enzoevers/piezo2midi/README.md

# piezo2midi

This project contains the hardware and software to read piezo inputs and convert them to a midi signal.

The main usecase is electronic drums. But it should be generic enough to be use by any piezo input.
