enzoevers/piezo2midi/Docs/Images/Piezo/FallstadPiezoModuleCircuit.png

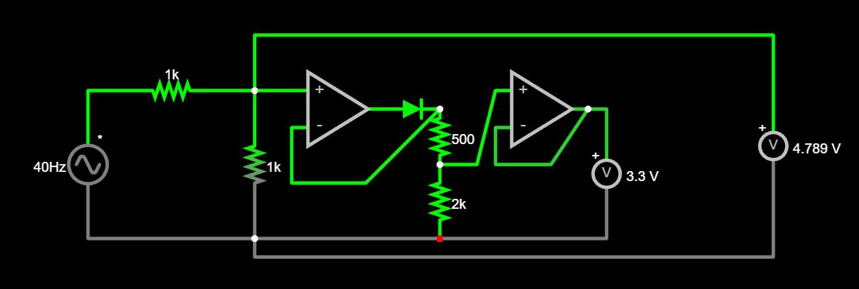
Docs/Images/Piezo/FallstadPiezoModuleCircuit.png
