enzoevers/piezo2midi/Docs/Images/Piezo/PiezoModuleInputCircuit.png

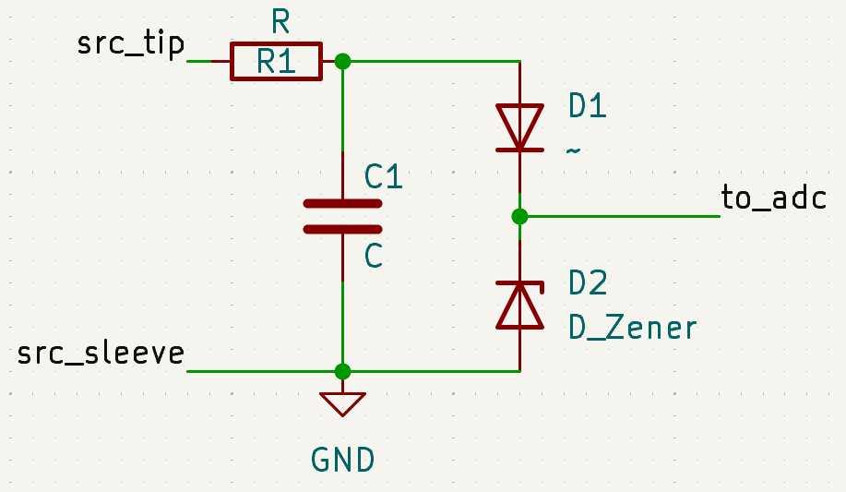
Docs/Images/Piezo/PiezoModuleInputCircuit.png
