enzoevers/piezo2midi/Docs/Images/Piezo/Scope/AlesisPad3v3ZenerAndDiodeHit.png

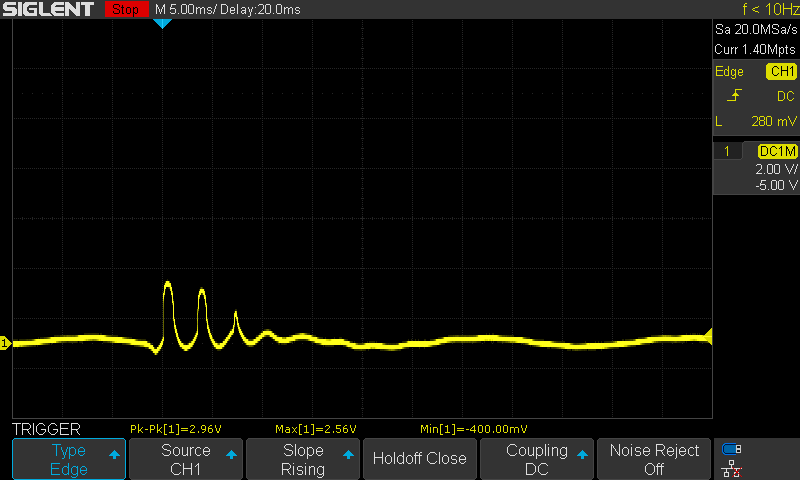
Docs/Images/Piezo/Scope/AlesisPad3v3ZenerAndDiodeHit.png
