enzoevers/piezo2midi/Docs/Images/Piezo/Scope/AlesisPad7v5ZenerAndDiodeHit1.png

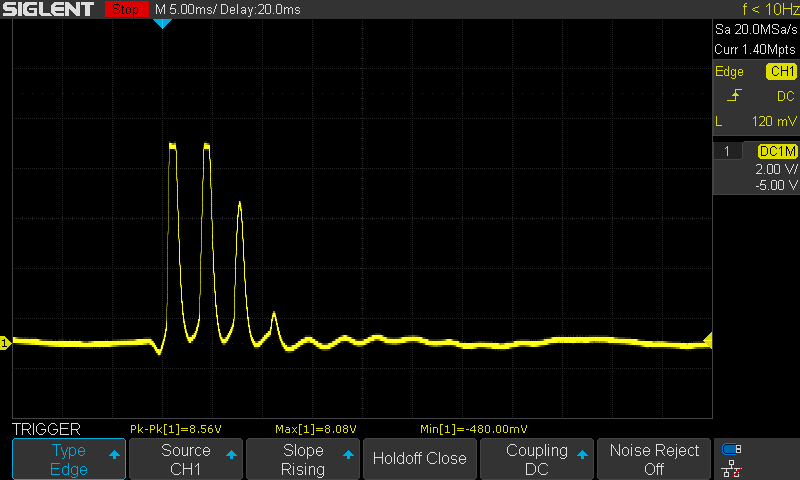
Docs/Images/Piezo/Scope/AlesisPad7v5ZenerAndDiodeHit1.png
