enzoevers/piezo2midi/Docs/Images/Piezo/Scope/AlesisPad7v5ZenerHit1.png

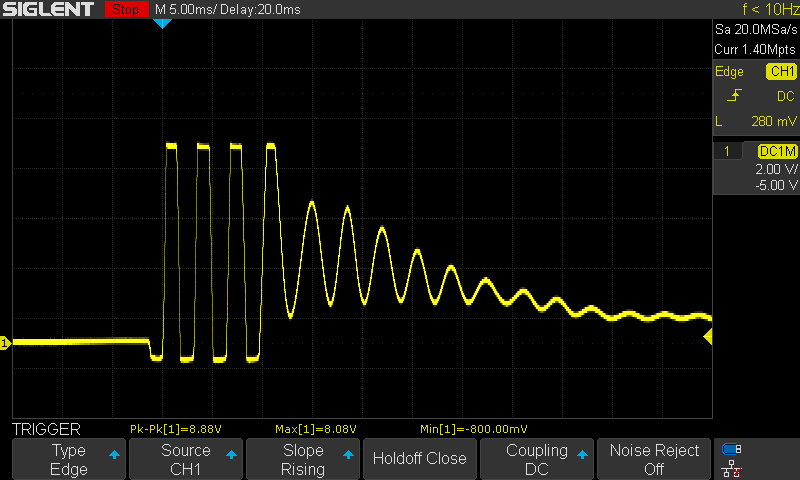
Docs/Images/Piezo/Scope/AlesisPad7v5ZenerHit1.png
