enzoevers/piezo2midi/Docs/Images/Piezo/Scope/AlesisPadHit1.png

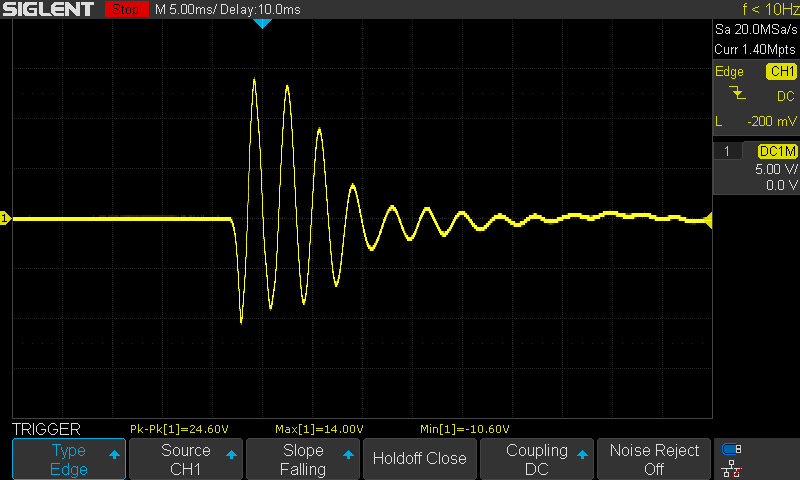
Docs/Images/Piezo/Scope/AlesisPadHit1.png
