enzoevers/piezo2midi/Docs/Images/Piezo/Scope/DIY8InchHit1.png

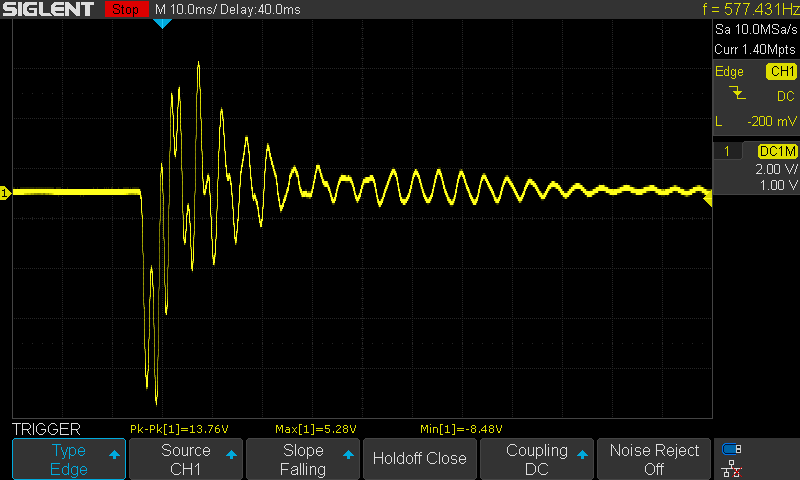
Docs/Images/Piezo/Scope/DIY8InchHit1.png
