enzoevers/piezo2midi/Docs/Images/Piezo/Scope/DIY10InchHit1.png

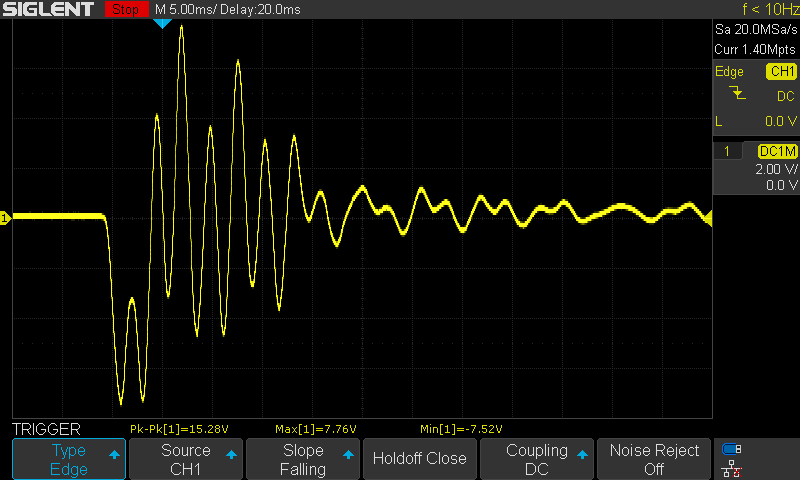
Docs/Images/Piezo/Scope/DIY10InchHit1.png
