enzoevers/piezo2midi/Docs/Images/Piezo/Scope/DIY10InchHit2.png

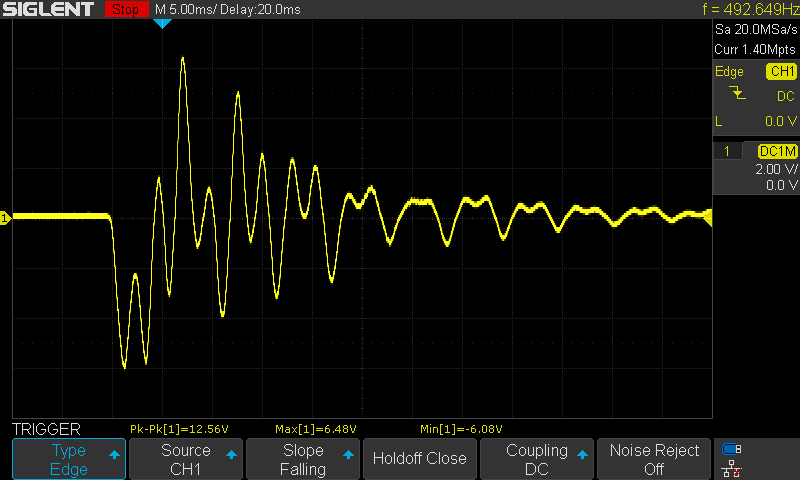
Docs/Images/Piezo/Scope/DIY10InchHit2.png
