enzoevers/piezo2midi/Docs/Images/Piezo/Scope/OpAmpScalerVcc20V.png

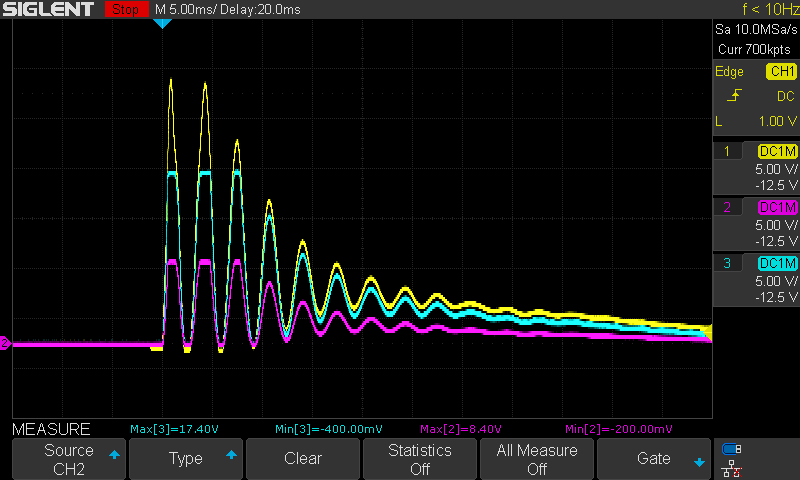
Docs/Images/Piezo/Scope/OpAmpScalerVcc20V.png
