enzoevers/piezo2midi/Docs/Images/Piezo/Scope/OpAmpVcc20VDiodeOnOutput.png

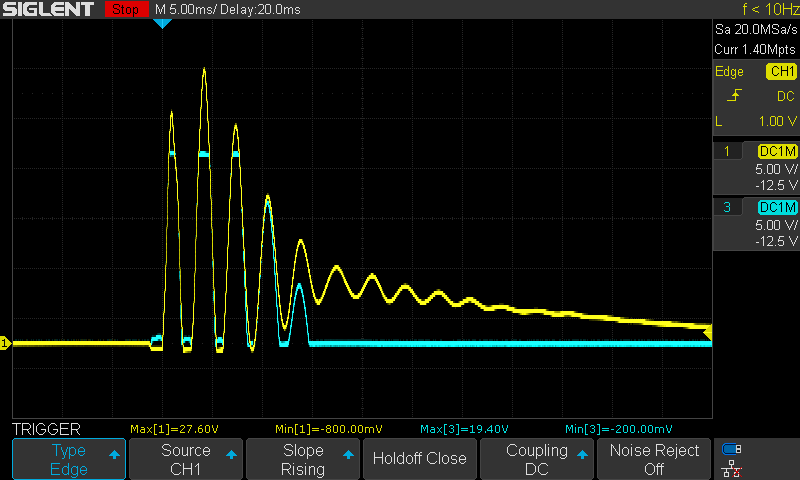
Docs/Images/Piezo/Scope/OpAmpVcc20VDiodeOnOutput.png
