enzoevers/piezo2midi/KiCAD/MouserModels/LIB_MCP3008-I_SL/MCP3008-I_SL/3D/MCP3008-I_SL.stp

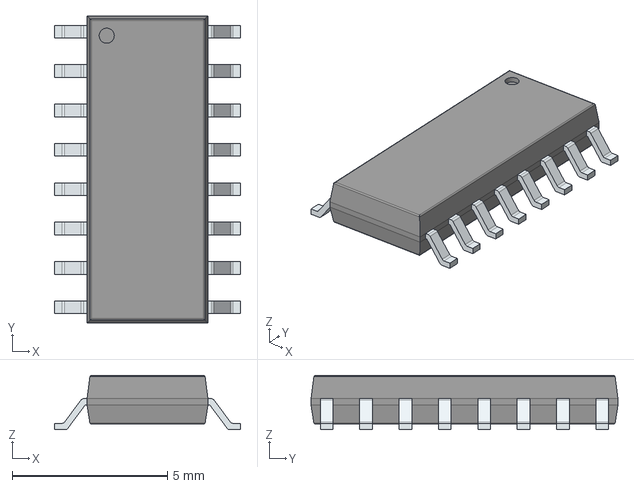
[picture p48: CAD file, 2026-08-01]
KiCAD/MouserModels/LIB_MCP3008-I_SL/MCP3008-I_SL/3D/MCP3008-I_SL.stp
6.00 x 9.90 x 1.75 mm
PinsArrayLR
