enzoevers/piezo2midi/KiCAD/MouserModels/LIB_S3B-PH-SM4-TB_LF__SN_/S3B-PH-SM4-TB_LF__SN_/3D/S3B-PH-SM4-TB_LF__SN_.stp

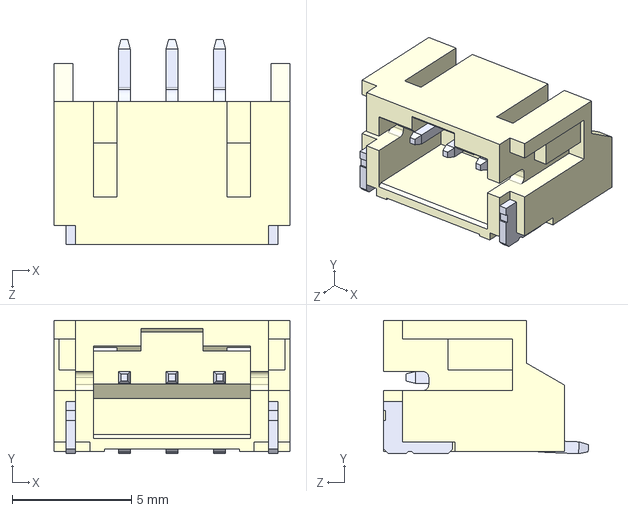
[picture p49: CAD file, 2026-08-01]
KiCAD/MouserModels/LIB_S3B-PH-SM4-TB_LF__SN_/S3B-PH-SM4-TB_LF__SN_/3D/S3B-PH-SM4-TB_LF__SN_.stp
9.90 x 5.60 x 8.60 mm
