enzoevers/piezo2midi/KiCAD/PiezoCircuit/PiezoCircuit/PiezoCircuit.kicad_pcb

## KiCad design KiCAD/PiezoCircuit/PiezoCircuit/PiezoCircuit.kicad_pcb (2026-08-01)

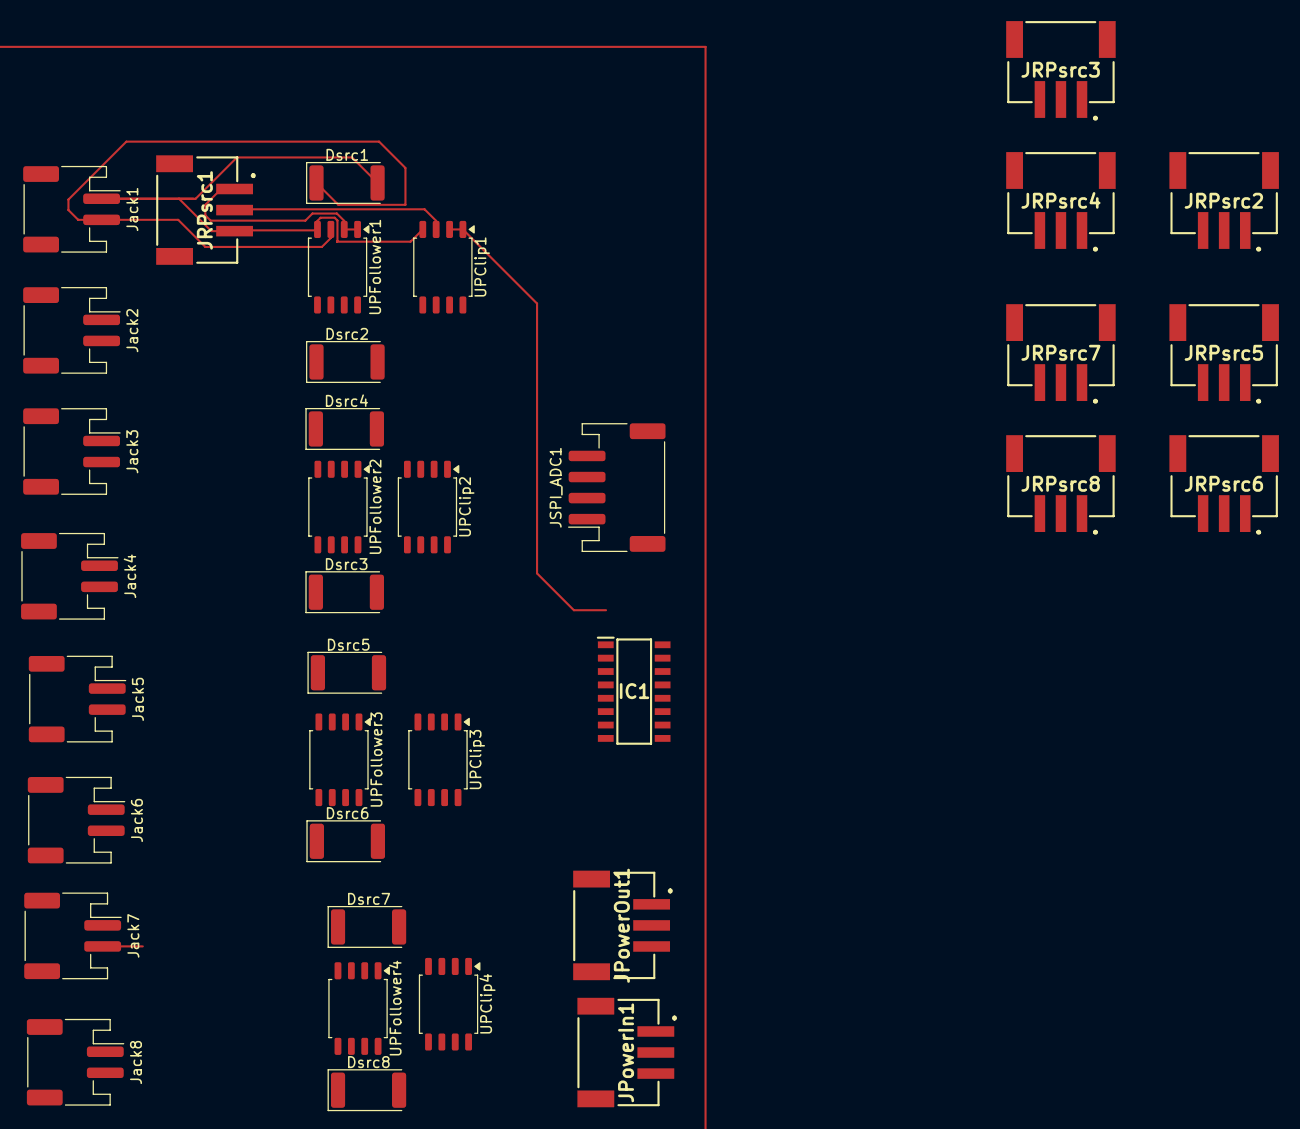
[picture p50: board PiezoCircuit.kicad_pcb from above]

Board: 2 copper layers, 36 parts (0 on the bottom side), 40 nets.

Parts:
Dsrc1, Dsrc2, Dsrc3, Dsrc4, Dsrc5, Dsrc6, Dsrc7, Dsrc8: D_2512_6332Metric
IC1: MCP3008-I_SL; SOIC127P600X175-16N
JPowerIn1: S3B-PH-SM4-TB_LF__SN_; S3BPHSM4TBLFSN
JPowerOut1: S3B-PH-SM4-TB_LF__SN_; S3BPHSM4TBLFSN
JRPsrc1, JRPsrc2, JRPsrc3, JRPsrc4, JRPsrc5, JRPsrc6, JRPsrc7, JRPsrc8: S3B-PH-SM4-TB_LF__SN_; S3BPHSM4TBLFSN
JSPI_ADC1: Conn_01x04; JST_PH_S4B-PH-SM4-TB_1x04-1MP_P2.00mm_Horizontal
Jack1, Jack2, Jack3, Jack4, Jack5, Jack6, Jack7, Jack8: Conn_01x02; JST_PH_S2B-PH-SM4-TB_1x02-1MP_P2.00mm_Horizontal
UPClip1, UPClip2, UPClip3, UPClip4: LM358; SOIC-8_5.3x5.3mm_P1.27mm
UPFollower1, UPFollower2, UPFollower3, UPFollower4: LM358; SOIC-8_5.3x5.3mm_P1.27mm

Connections:
+5V: IC1.15 (VREF), IC1.16 (VDD)
/SPI_CLK_ADC: IC1.13 (CLK), JSPI_ADC1.4
/SPI_MISO_ADC: IC1.12 (DOUT), JSPI_ADC1.3
/SPI_MOSI_ADC: IC1.11 (DIN), JSPI_ADC1.2
/ScaledInput0: IC1.1 (CH0), UPClip1.1, UPClip1.2 (-)
/ScaledInput1: IC1.2 (CH1), UPClip1.6 (-), UPClip1.7
/ScaledInput2: IC1.3 (CH2), UPClip2.1, UPClip2.2 (-)
/ScaledInput3: IC1.4 (CH3), UPClip2.6 (-), UPClip2.7
/ScaledInput4: IC1.5 (CH4), UPClip3.1, UPClip3.2 (-)
/ScaledInput5: IC1.6 (CH5), UPClip3.6 (-), UPClip3.7
/ScaledInput6: IC1.7 (CH6), UPClip4.1, UPClip4.2 (-)
/ScaledInput7: IC1.8 (CH7), UPClip4.6 (-), UPClip4.7
/VMCUref: JPowerIn1.3, JPowerOut1.3
/VPiezoRef: JPowerIn1.1, JPowerOut1.1
/src_tip_0: Dsrc1.1 (K), Jack1.2, UPFollower1.3 (+)
/src_tip_1: Dsrc2.1 (K), Jack2.2, UPFollower1.5 (+)
/src_tip_2: Dsrc3.1 (K), Jack3.2, UPFollower2.3 (+)
/src_tip_3: Dsrc4.1 (K), Jack4.2, UPFollower2.5 (+)
/src_tip_4: Dsrc5.1 (K), Jack5.2, UPFollower3.3 (+)
/src_tip_5: Dsrc6.1 (K), Jack6.2, UPFollower3.5 (+)
/src_tip_6: Dsrc7.1 (K), Jack7.2, UPFollower4.3 (+)
/src_tip_7: Dsrc8.1 (K), Jack8.2, UPFollower4.5 (+)
/~SPI_CS_ADC: IC1.10 (~CS/SHDN), JSPI_ADC1.1
GND: Dsrc1.2 (A), Dsrc2.2 (A), Dsrc3.2 (A), Dsrc4.2 (A), Dsrc5.2 (A), Dsrc6.2 (A), Dsrc7.2 (A), Dsrc8.2 (A), IC1.9 (DGND), IC1.14 (AGND), JPowerIn1.2, JPowerOut1.2, JRPsrc1.3, JRPsrc2.3, JRPsrc3.3, JRPsrc4.3, JRPsrc5.3, JRPsrc6.3, JRPsrc7.3, JRPsrc8.3, Jack1.1, Jack2.1, Jack3.1, Jack4.1, Jack5.1, Jack6.1, Jack7.1, Jack8.1, UPClip1.4 (V-), UPClip2.4 (V-), UPClip3.4 (V-), UPClip4.4 (V-), UPFollower1.4 (V-), UPFollower2.4 (V-), UPFollower3.4 (V-), UPFollower4.4 (V-)
unnamed: JRPsrc1.2, UPClip1.3 (+)
unnamed: JRPsrc2.2, UPClip1.5 (+)
unnamed: JRPsrc3.2, UPClip2.3 (+)
unnamed: JRPsrc4.2, UPClip2.5 (+)
unnamed: JRPsrc5.2, UPClip3.3 (+)
unnamed: JRPsrc6.2, UPClip3.5 (+)
unnamed: JRPsrc7.2, UPClip4.3 (+)
unnamed: JRPsrc8.2, UPClip4.5 (+)
unnamed: JRPsrc1.1, UPFollower1.1, UPFollower1.2 (-)
unnamed: JRPsrc2.1, UPFollower1.6 (-), UPFollower1.7
unnamed: JRPsrc3.1, UPFollower2.1, UPFollower2.2 (-)
unnamed: JRPsrc4.1, UPFollower2.6 (-), UPFollower2.7
unnamed: JRPsrc5.1, UPFollower3.1, UPFollower3.2 (-)
unnamed: JRPsrc6.1, UPFollower3.6 (-), UPFollower3.7
unnamed: JRPsrc7.1, UPFollower4.1, UPFollower4.2 (-)
unnamed: JRPsrc8.1, UPFollower4.6 (-), UPFollower4.7
