enzoevers/piezo2midi/Code/Communication/private/UART/hardware/IOProxy_UART_AVR_PeripheralMap.h

#pragma once
#include <avr/io.h>
#include <stdint.h>

static auto GetUDRAddress(uint8_t uartId) -> volatile uint8_t * {
  switch (uartId) {
#ifdef UDR0
  case 0:
    return &UDR0;
#endif
#ifdef UDR1
  case 1:
    return &UDR1;
#endif
  default:
    return nullptr;
  }
}

static auto GetUCSRnAAddress(uint8_t uartId) -> volatile uint8_t * {
  switch (uartId) {
#ifdef UCSR0A
  case 0:
    return &UCSR0A;
#endif
#ifdef UCSR1A
  case 1:
    return &UCSR1A;
#endif
  default:
    return nullptr;
  }
}

static auto GetUCSRnBAddress(uint8_t uartId) -> volatile uint8_t * {
  switch (uartId) {
#ifdef UCSR0B
  case 0:
    return &UCSR0B;
#endif
#ifdef UCSR1B
  case 1:
    return &UCSR1B;
#endif
  default:
    return nullptr;
  }
}

static auto GetUCSRnCAddress(uint8_t uartId) -> volatile uint8_t * {
  switch (uartId) {
#ifdef UCSR0C
  case 0:
    return &UCSR0C;
#endif
#ifdef UCSR1C
  case 1:
    return &UCSR1C;
#endif
  default:
    return nullptr;
  }
}

static auto GetUBRRnLAddress(uint8_t uartId) -> volatile uint8_t * {
  switch (uartId) {
#ifdef UBRR0L
  case 0:
    return &UBRR0L;
#endif
#ifdef UBRR1L
  case 1:
    return &UBRR1L;
#endif
  default:
    return nullptr;
  }
}

static auto GetUBRRnHAddress(uint8_t uartId) -> volatile uint8_t * {
  switch (uartId) {
#ifdef UBRR0H
  case 0:
    return &UBRR0H;
#endif
#ifdef UBRR1H
  case 1:
    return &UBRR1H;
#endif
  default:
    return nullptr;
  }
}

static auto GetRXCnValue(uint8_t uartId) -> uint8_t {
  switch (uartId) {
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
#endif
#ifdef UPM11
  case 1:
    return UPM11;
#endif
  default:
    return 0;
  }
}

static auto GetUSBSnValue(uint8_t uartId) -> uint8_t {
  switch (uartId) {
#ifdef USBS0
  case 0:
    return USBS0;
#endif
#ifdef USBS1
  case 1:
    return USBS1;
#endif
  default:
    return 0;
  }
}

static auto GetUCSZn1Value(uint8_t uartId) -> uint8_t {
  switch (uartId) {
#ifdef UCSZ01
  case 0:
    return UCSZ01;
#endif
#ifdef UCSZ11
  case 1:
    return UCSZ11;
#endif
  default:
    return 0;
  }
}

static auto GetUCSZn0Value(uint8_t uartId) -> uint8_t {
  switch (uartId) {
#ifdef UCSZ00
  case 0:
    return UCSZ00;
#endif
#ifdef UCSZ10
  case 1:
    return UCSZ10;
#endif
  default:
    return 0;
  }
}

static auto GetUCPOLnValue(uint8_t uartId) -> uint8_t {
  switch (uartId) {
#ifdef UCPOL0
  case 0:
    return UCPOL0;
#endif
#ifdef UCPOL1
  case 1:
    return UCPOL1;
#endif
  default:
    return 0;
  }
}
