enzoevers/piezo2midi/(commit log)

2025-11-14 Describe piezo circuit
    [AlesisDM6_PadJackOutput.kicad_pcb, AlesisDM6_PadJackOutput.kicad_sch, PiezoCircuit.kicad_pcb, PiezoCircuit.kicad_sch]
2025-11-30 Describe the software requirements and high-level flow of the code
2025-11-30 Cleaning up the documentation
    [PiezoCircuit.kicad_sch]
2025-12-24 Update piezo input circuit
    [PiezoCircuit.kicad_sch]
2026-04-02 Setup the software structure for cross-platform development and testing. Additionally, implement basic DigitalIO and UART implementations for AVR microcontrollers.
2026-04-04 Implement SPI for AVR and mocks
2026-04-04 Update SPI to only change the mentioned slave select line. Add DeselectSlave(...)
2026-04-04 Add image of Arduino uno pinout
2026-04-06 Create a single function for the UART tests to create the ON_CALLS for ReadDefine
2026-08-01 Create InstrumentApp
    [MCP3008-I_SL.stp, PiezoCircuit.kicad_pcb, PiezoCircuit.kicad_sch, S3B-PH-SM4-TB_LF__SN_.stp, untitled.kicad_sch]
